vonkratzmann/GoKartMkIV/Motor Size Image.docx

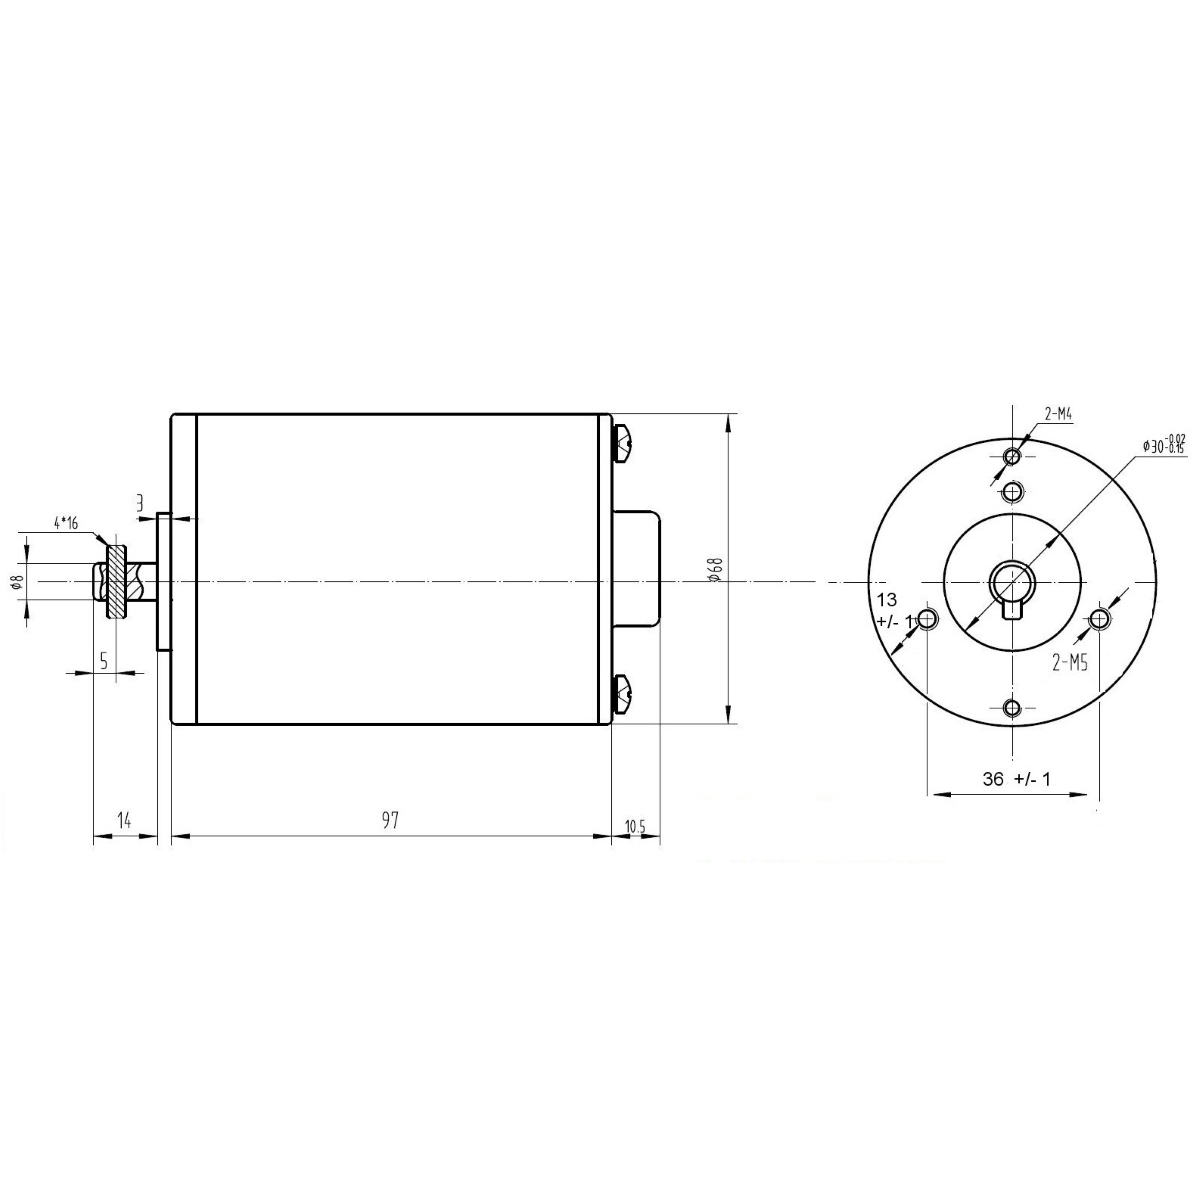
[picture p1: figure]
