vonkratzmann/GoKartMkIV/Go Kart Specifications V1.xlsx

Wheel Dia | Max Speed | Child Weight (10 year old) | Battery Weight | Kart Weight | Motor Weight | Total Weight | Time to Max Spd | # of Wheels | Losses | Power/Wheel | Torque/Wheel | Wheel Speed | Wheel Sprocket | Gear Ratio | Motor Sprocket | Motor Speed | Max Spro. Dia
(mm) | (km/h) | (kg) | (20AH) | (kg) | (kg) | (kg) | (secs) | (driven) | (%) | (Watts) | (NM) | (RPM) | (Teeth) |  | (Teeth) | (RPM) | mm
150 | 15 | 20 | 6 | 15 | 2.8 | 43.8 | 5 | 2 | 25% | 101.4328431 | 1.8 | 530.7855626 | 49.5 | 5.5 | 9 | 2919.320594 | 50
200 | 15 | 20 | 6 | 15 | 2.8 | 43.8 | 5 | 2 | 25% | 101.4328431 | 2.4 | 398.089172 | 63 | 7 | 9 | 2786.624204 | 100
250 | 15 | 20 | 6 | 15 | 2.8 | 43.8 | 5 | 2 | 25% | 101.4328431 | 3.0 | 318.4713376 | 67.5 | 7.5 | 9 | 2388.535032 | 150
300 | 15 | 20 | 6 | 15 | 2.8 | 43.8 | 5 | 2 | 25% | 101.4328431 | 3.6 | 265.3927813 | 90 | 10 | 9 | 2653.927813 | 200
Fixed Specifications
 | Ground clearance |  | 50 | mm
 | Seat Size |  | 350 * 250 | mm |  |  |  |  |  | Max Speed based on motor speed working range and gear ratio for 250mm dia wheel
 | Maximum Width |  | 400 | mm |  |  |  |  |  | 19.1184
Other Specifications
Specifications of purchased motor
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
