vonkratzmann/GoKartMkIV/(list of files, cad)

Other CAD files:
GoKartMkIV Axle V1.skp
GoKartMkIVver1.skp
GoKartMkIVver2.skp
My Components/Axle Clamp V4.skp
My Components/Battery.skp
My Components/Brake V1.skp
My Components/Complete Axle_ Wheel_ Sprocket_ Axle Clamps.skp
My Components/Electronics V1.skp
My Components/Foot Rest.skp
My Components/Frame Front.skp
My Components/Frame Left.skp
My Components/Frame Rear.skp
My Components/Frame Right.skp
My Components/Hex Nut M10.skp
My Components/Seat Yellow Leather.skp
My Components/Sprocket V2.skp
My Components/Steel Sleeve ID 10mm_ OD 12mm_ L 2mm.skp
My Components/Washer M10.skp
My Components/Wheel Support.skp
My Components/Wheels and Wheel Supports.skp
My Components/castor_2-0515.skp
My Components/etrac_motor.skp
timimg disc_v1.skp
