vonkratzmann/GoKartMkIV/(list of files, drawings)

Other design files:
GoKartMkIV.dsn
