vonkratzmann/GoKartMkIV/(commit log)

2017-12-14 first cut of code yet to be tested
    [Axle Clamp V4.skp, Battery.skp, Brake V1.skp, Complete Axle_ Wheel_ Sprocket_ Axle Clamps.skp, Electronics V1.skp, Foot Rest.skp, Frame Front.skp, Frame Left.skp]
2017-12-28 add a constant to limit the reverse speed
    [JoyStick.cpp]
2018-01-01 fixed bug added slower acceleration when moving forward
    [GoKartMKIII.h, JoyStick.cpp]
2018-01-02 testing have the drive wheels at the front of the Kart rather tha rear
2018-01-24 initial sketch
    [GoKartMkIV Axle V1.skp, GoKartMkIVver1.skp]
2018-02-17 updated all file names to MkIV
    [GoKartMkIV.dsn, GoKartMkIVver2.skp, bush.skp, nothing.skp, wheel.skp]
2018-02-25 first partially completed version of slotted disk class
2018-02-27 before make PID changes
2018-02-28 first version of code with two pid loops
2018-02-28 changed to one PID loop
2018-03-01 tested code, but slotted disk not working
    [GoKartMkIV.h, GoKartMkIV.ino, JoyStick.cpp, motor.cpp, slotteddisk.cpp, slotteddisk.h]
2018-03-01 change the slotted wheel detector to an ISR, could not get the 100 slot wheel to work
2018-03-02 changed slot size from 100 to 8; simplified class slotteddisk
2018-03-03 added noise check to the ISR for the slotted disk, also fixed a bug in ISR as it was only measuring the time for the width of a slot not the time between slots
    [GoKartMkIV.h, GoKartMkIV.ino, slotteddisk.h]
2018-03-03 In ISR replaced digital read with a direct read of the PORT. In ISR changed some ints to longs as they were overflowing
    [TimeBetweenSlots.xlsx]
2018-03-04 fixed bug in calculate speed()
    [GoKartMkIV.ino, slotteddisk.cpp, slotteddisk.h]
2018-03-04 converted ISR to read sensor in microseconds rather than milliseconds
2018-03-04 average last 3 slot times to calculate the speed
2018-03-05 changed wheel size
    [Go Kart V3.skp, GoKartMkIV Axle V1.skp, GoKartMkIVver2.skp, bush.skp, nothing.skp, wheel.skp]
2018-03-08 added figures for a 75 mm wheel
    [TimeBetweenSlots.xlsx]
2018-03-26 added hardware diagnostics and changed left and right wheel pins to make the cabling easier
    [Go Kart Specifications V2.xlsx, GoKartMkIVver1.skp, GoKartMkIVver2.skp, TimeBetweenSlots.xlsx, mmpersec_to kmperhour 1.ods, timimg disc_v1.skp]
2018-03-30 version tested in working Kart, PID jumps erratically
    [mmpersec_to kmperhour 1.ods]
2018-03-31 removed timer ISR, replaced with call to millis()
    [GoKartMkIV.h, GoKartMkIV.ino, slotteddisk.cpp]
2018-04-01 changed from PID Library to local PID.cpp file
2018-04-01 tidied up new PID code
2018-04-05 version for testing with driver
2018-04-14 removed average from slottime calculation
2018-04-16 fixed bug in main loop count, and bugs introduced by previous change to PID to limit integral windup
    [GoKartMkIV.h, GoKartMkIV.ino, JoyStick.cpp, pid.cpp]
2018-04-17 version to try with driver after tuning on Mega board
